contactmridulhere-commits/ana-smart-glasses/hardware/docs/ana-main-render-bottom.png

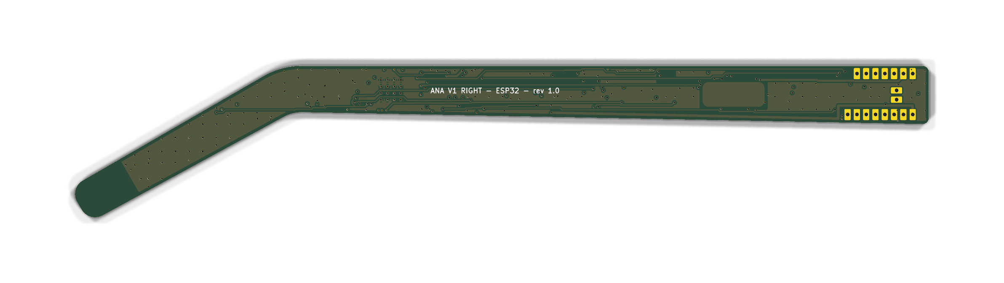
hardware/docs/ana-main-render-bottom.png
