contactmridulhere-commits/ana-smart-glasses/WhatsApp Image 2026-10-10 at 12.55.11 AM (2).jpeg

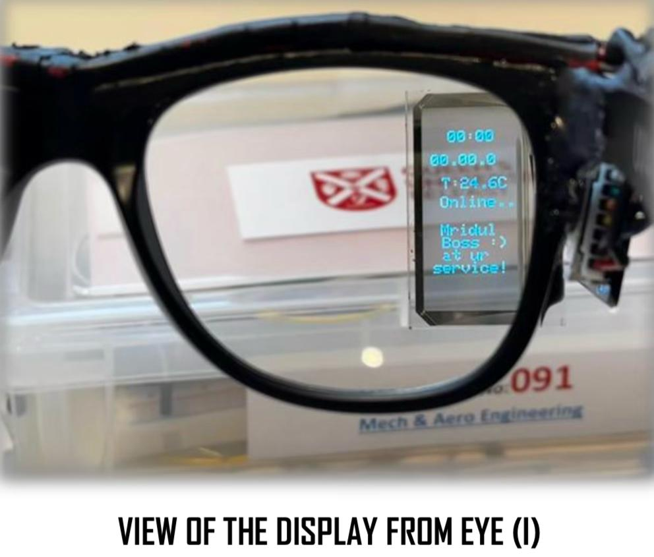
WhatsApp Image 2026-10-10 at 12.55.11 AM (2).jpeg
