contactmridulhere-commits/ana-smart-glasses/With LED's ON.jpeg

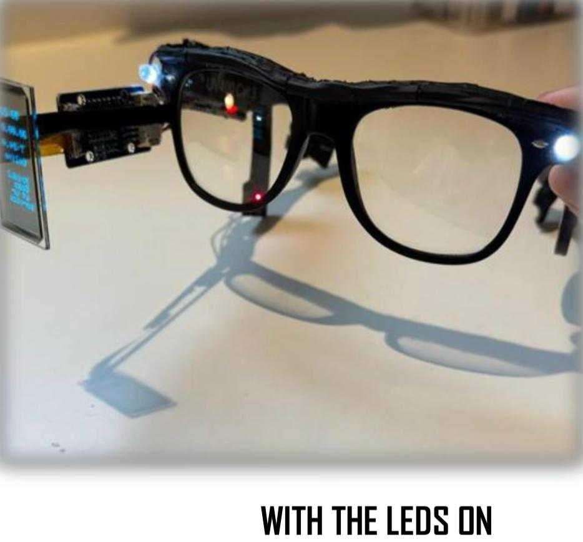
With LED's ON.jpeg
