contactmridulhere-commits/ana-smart-glasses/hardware/docs/ana-power-assembly-top.pdf

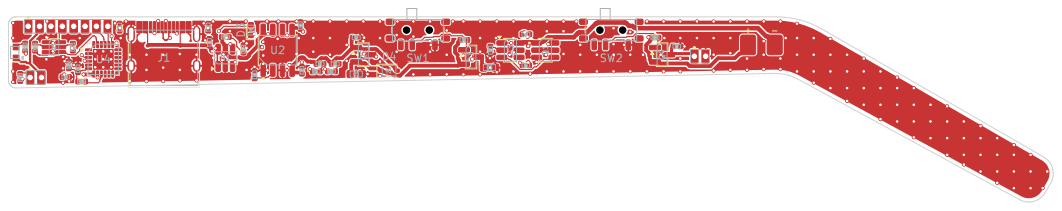
[picture p7: page 1]
