contactmridulhere-commits/ana-smart-glasses/hardware/docs/ana-power-schematic.pdf

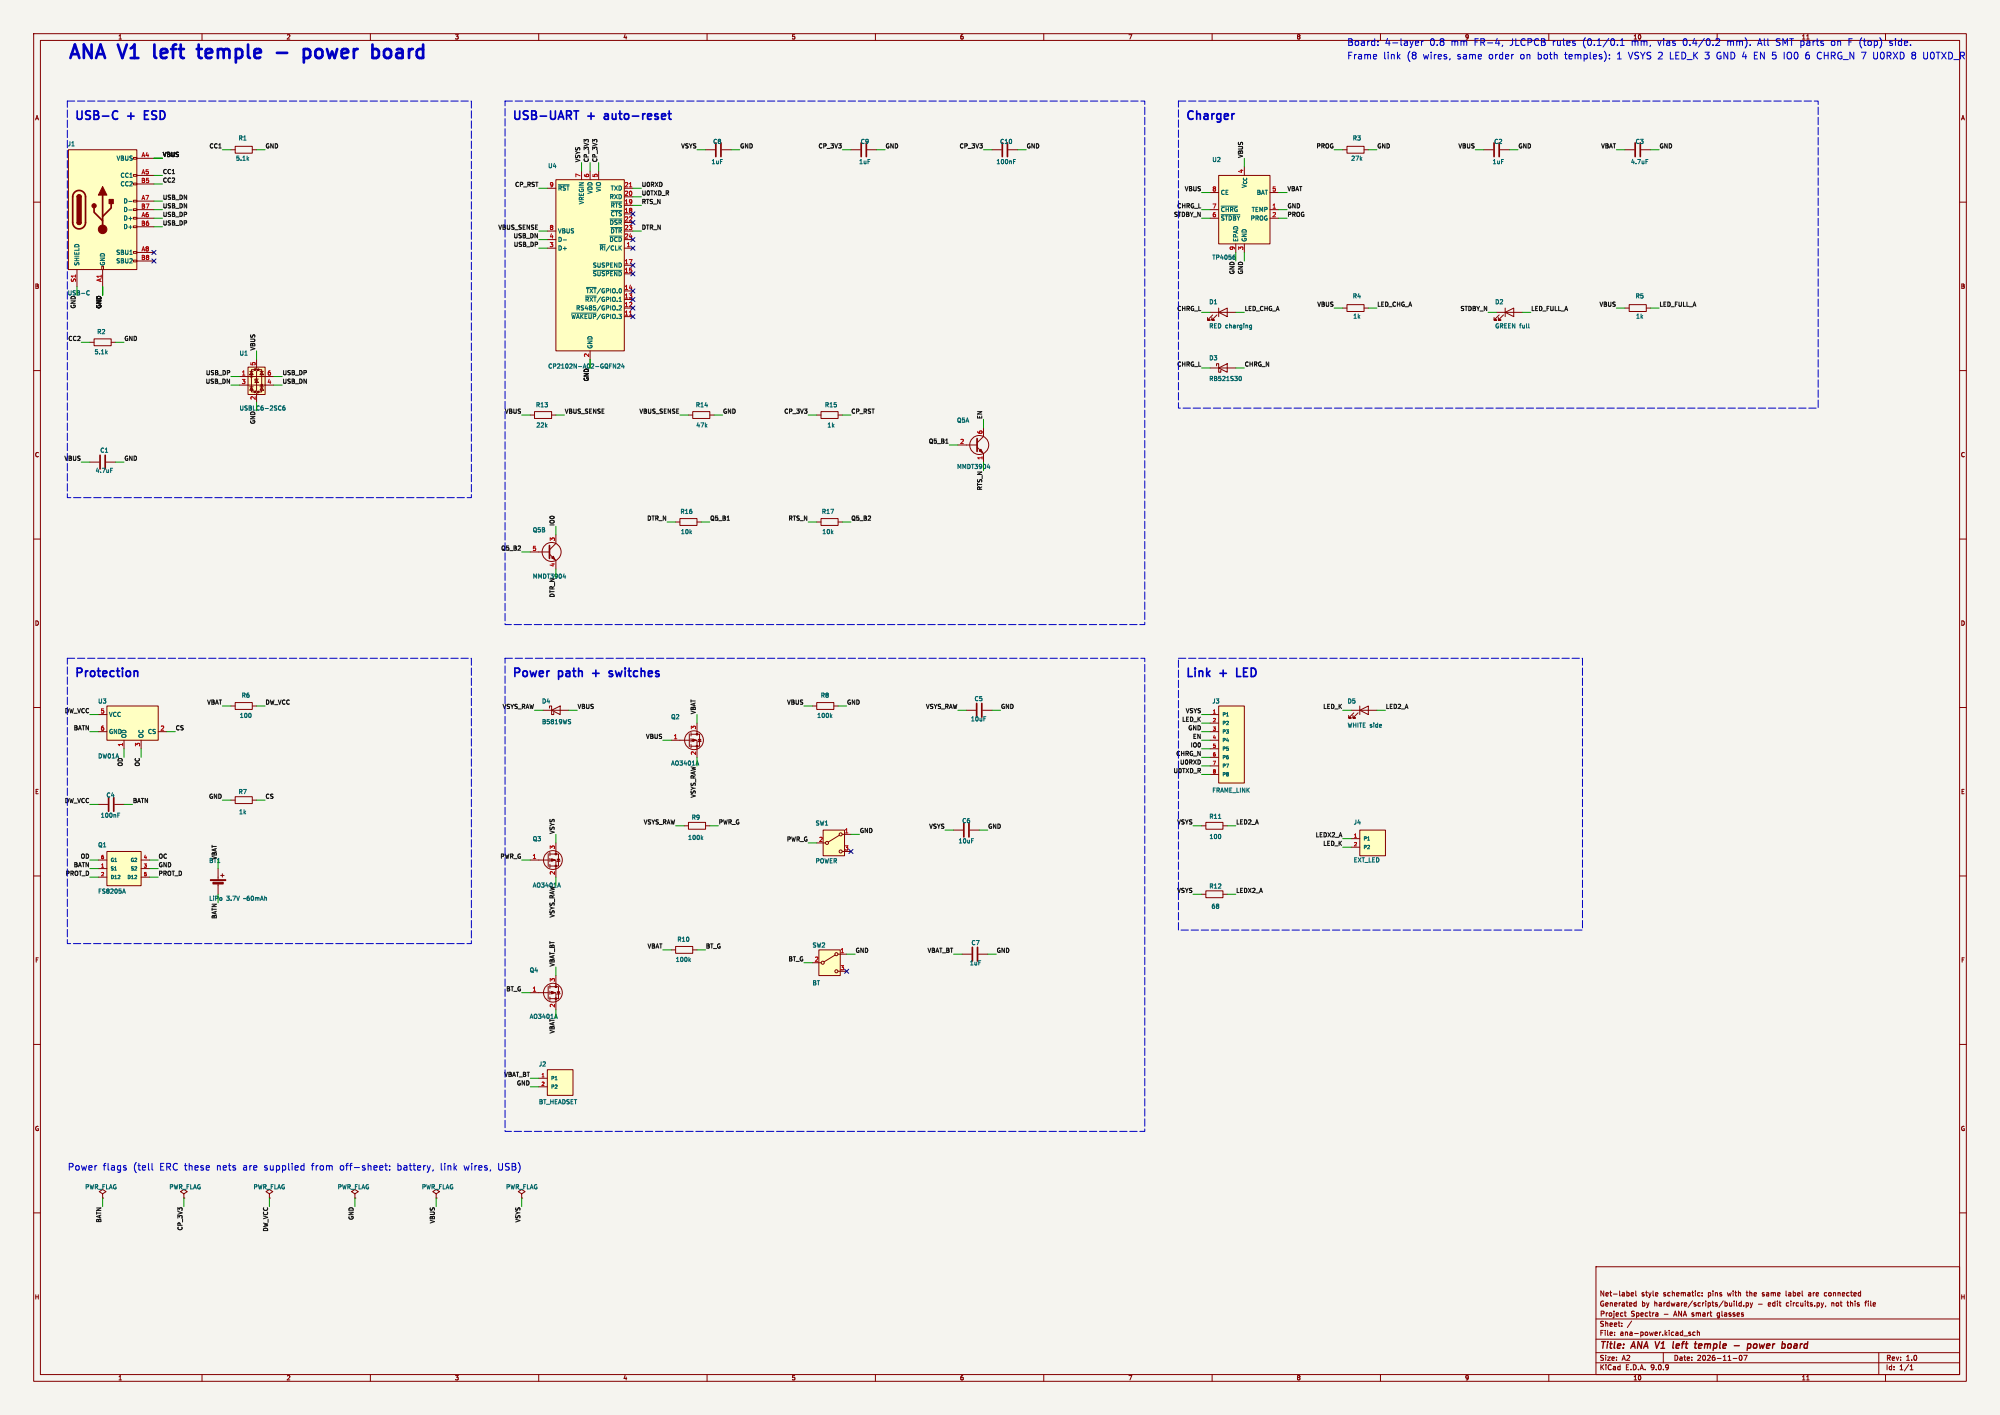
[picture p8: page 1]

5 TXD 21 RXD 20 ~{RTS} 19 ~{CTS} 18 ~{DSR} 22 ~{DTR} 23 ~{DCD} 24 ~{RI}/CLK1 SUSPEND 17 ~{SUSPEND}15 ~{TXT}/GPIO.014 ~{RXT}/GPIO.113 RS485/GPIO.2 12 ~{WAKEUP}/GPIO.311 U4 CP2102N-A02-GQFN24
