contactmridulhere-commits/ana-smart-glasses/hardware/ana-power/ana-power.kicad_pcb

## KiCad design hardware/ana-power/ana-power.kicad_pcb (2026-11-08)

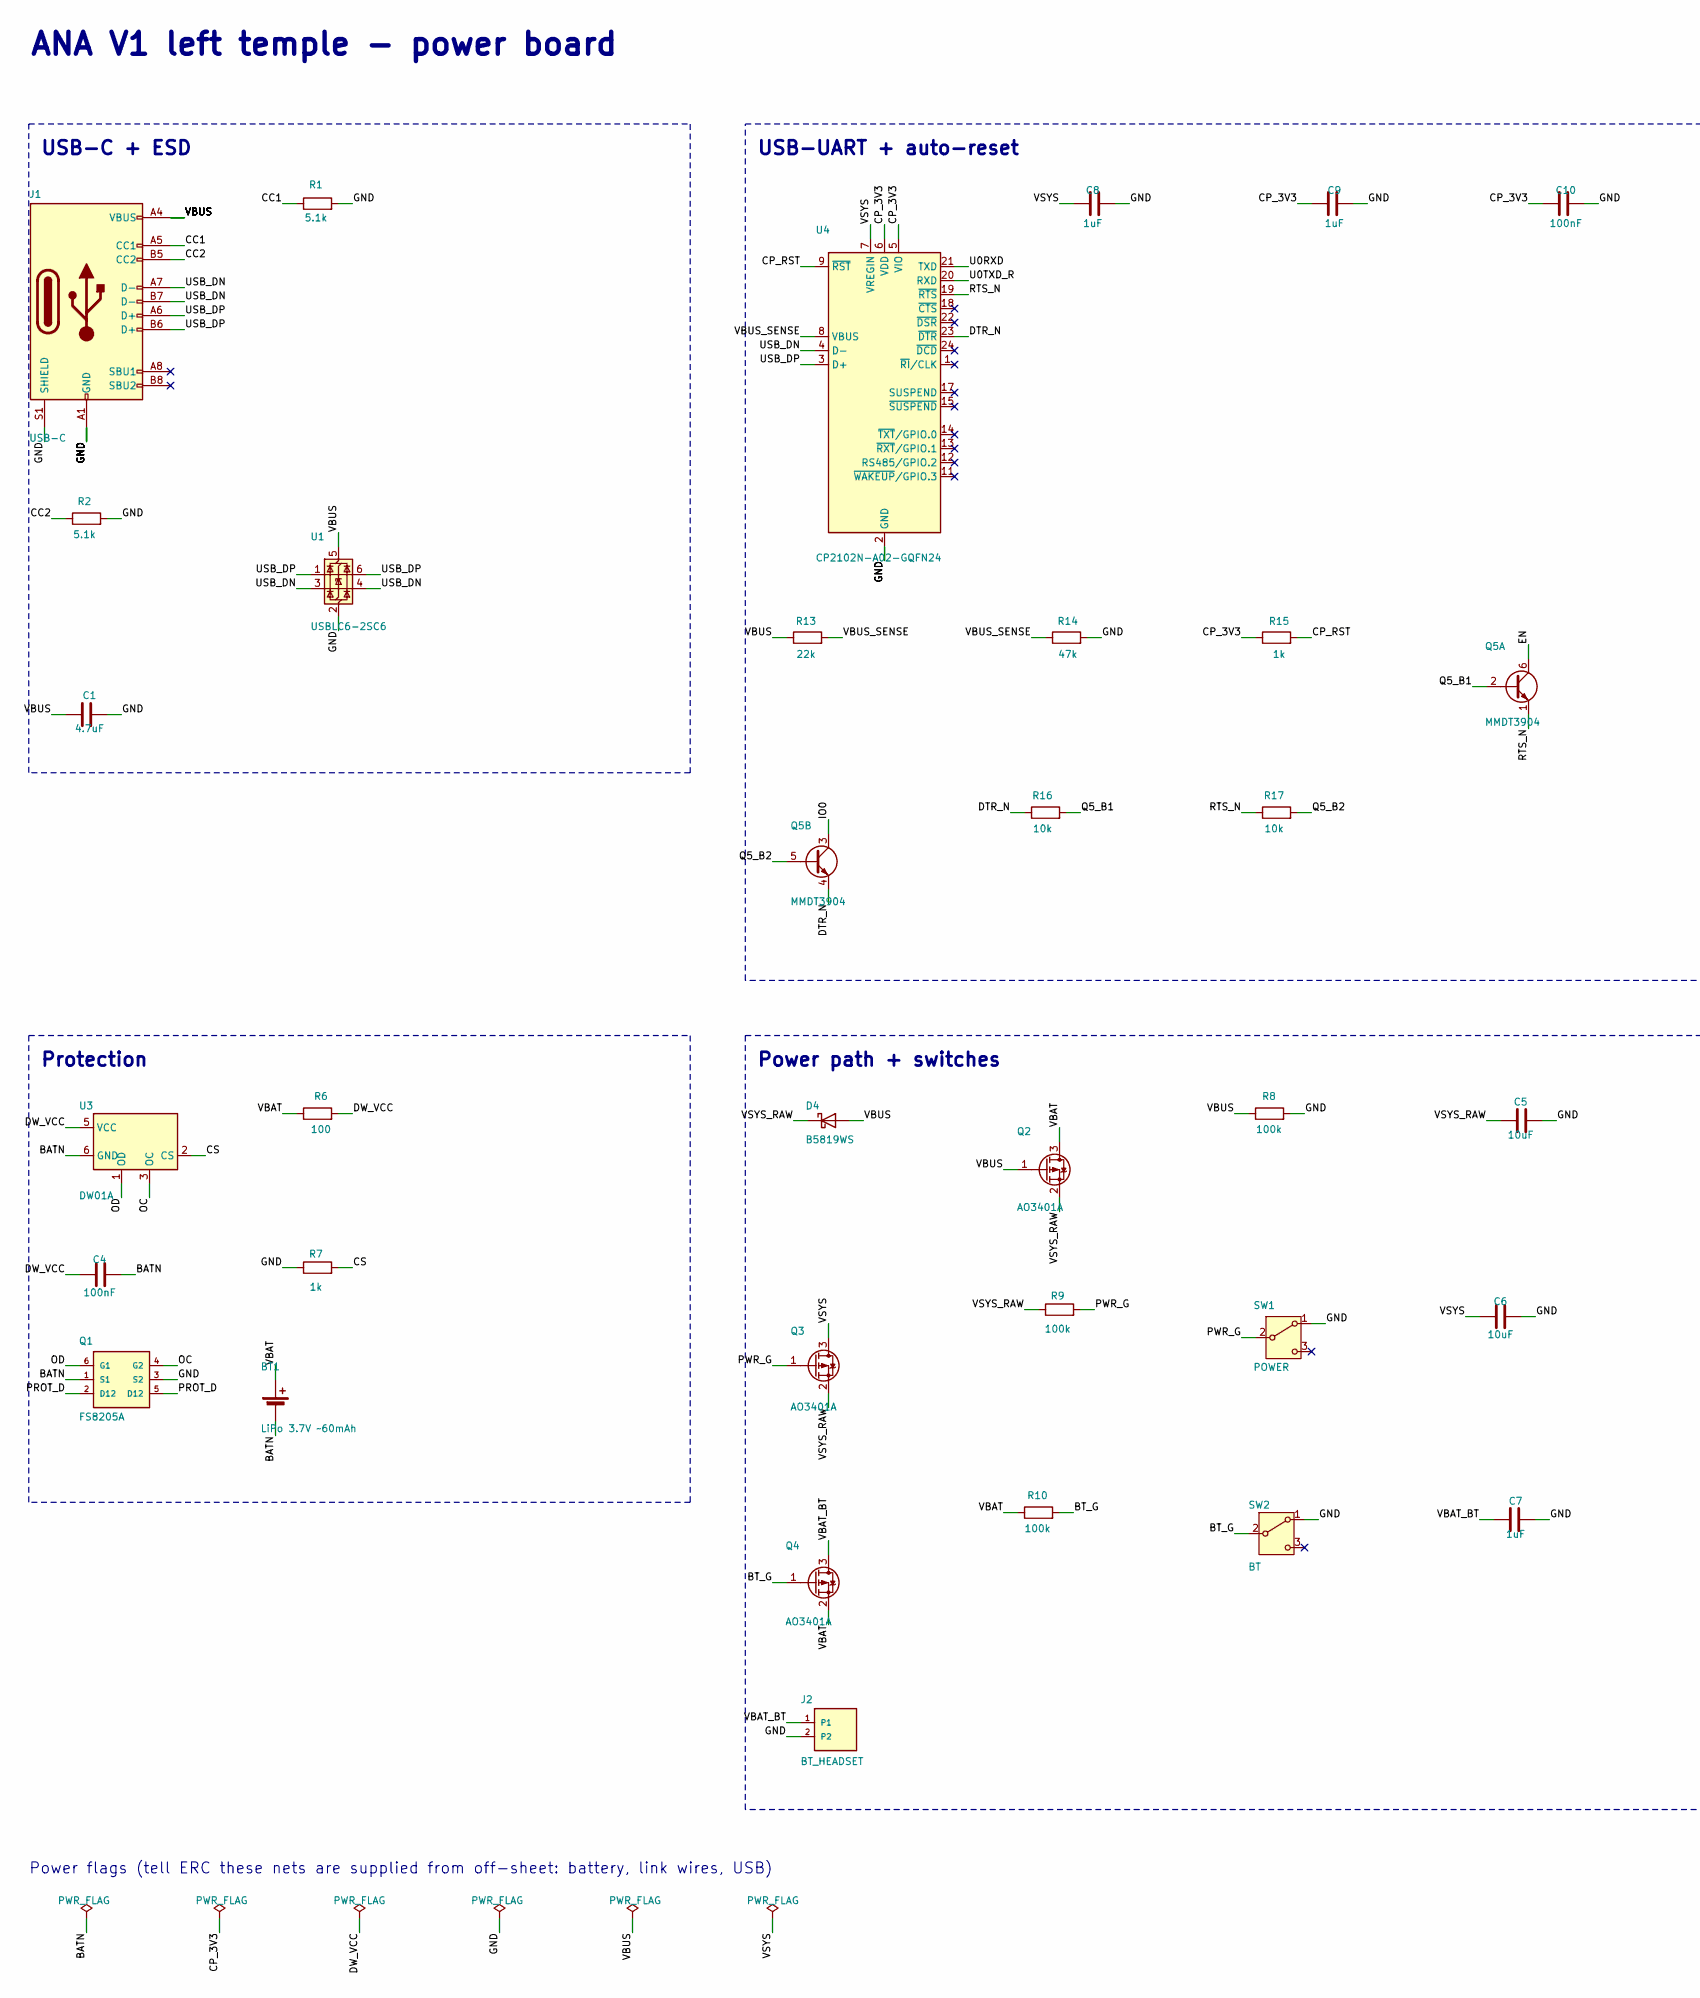
[picture p9: schematic ana-power.kicad_sch, ANA V1 left temple - power board, part in row 1, column 1]

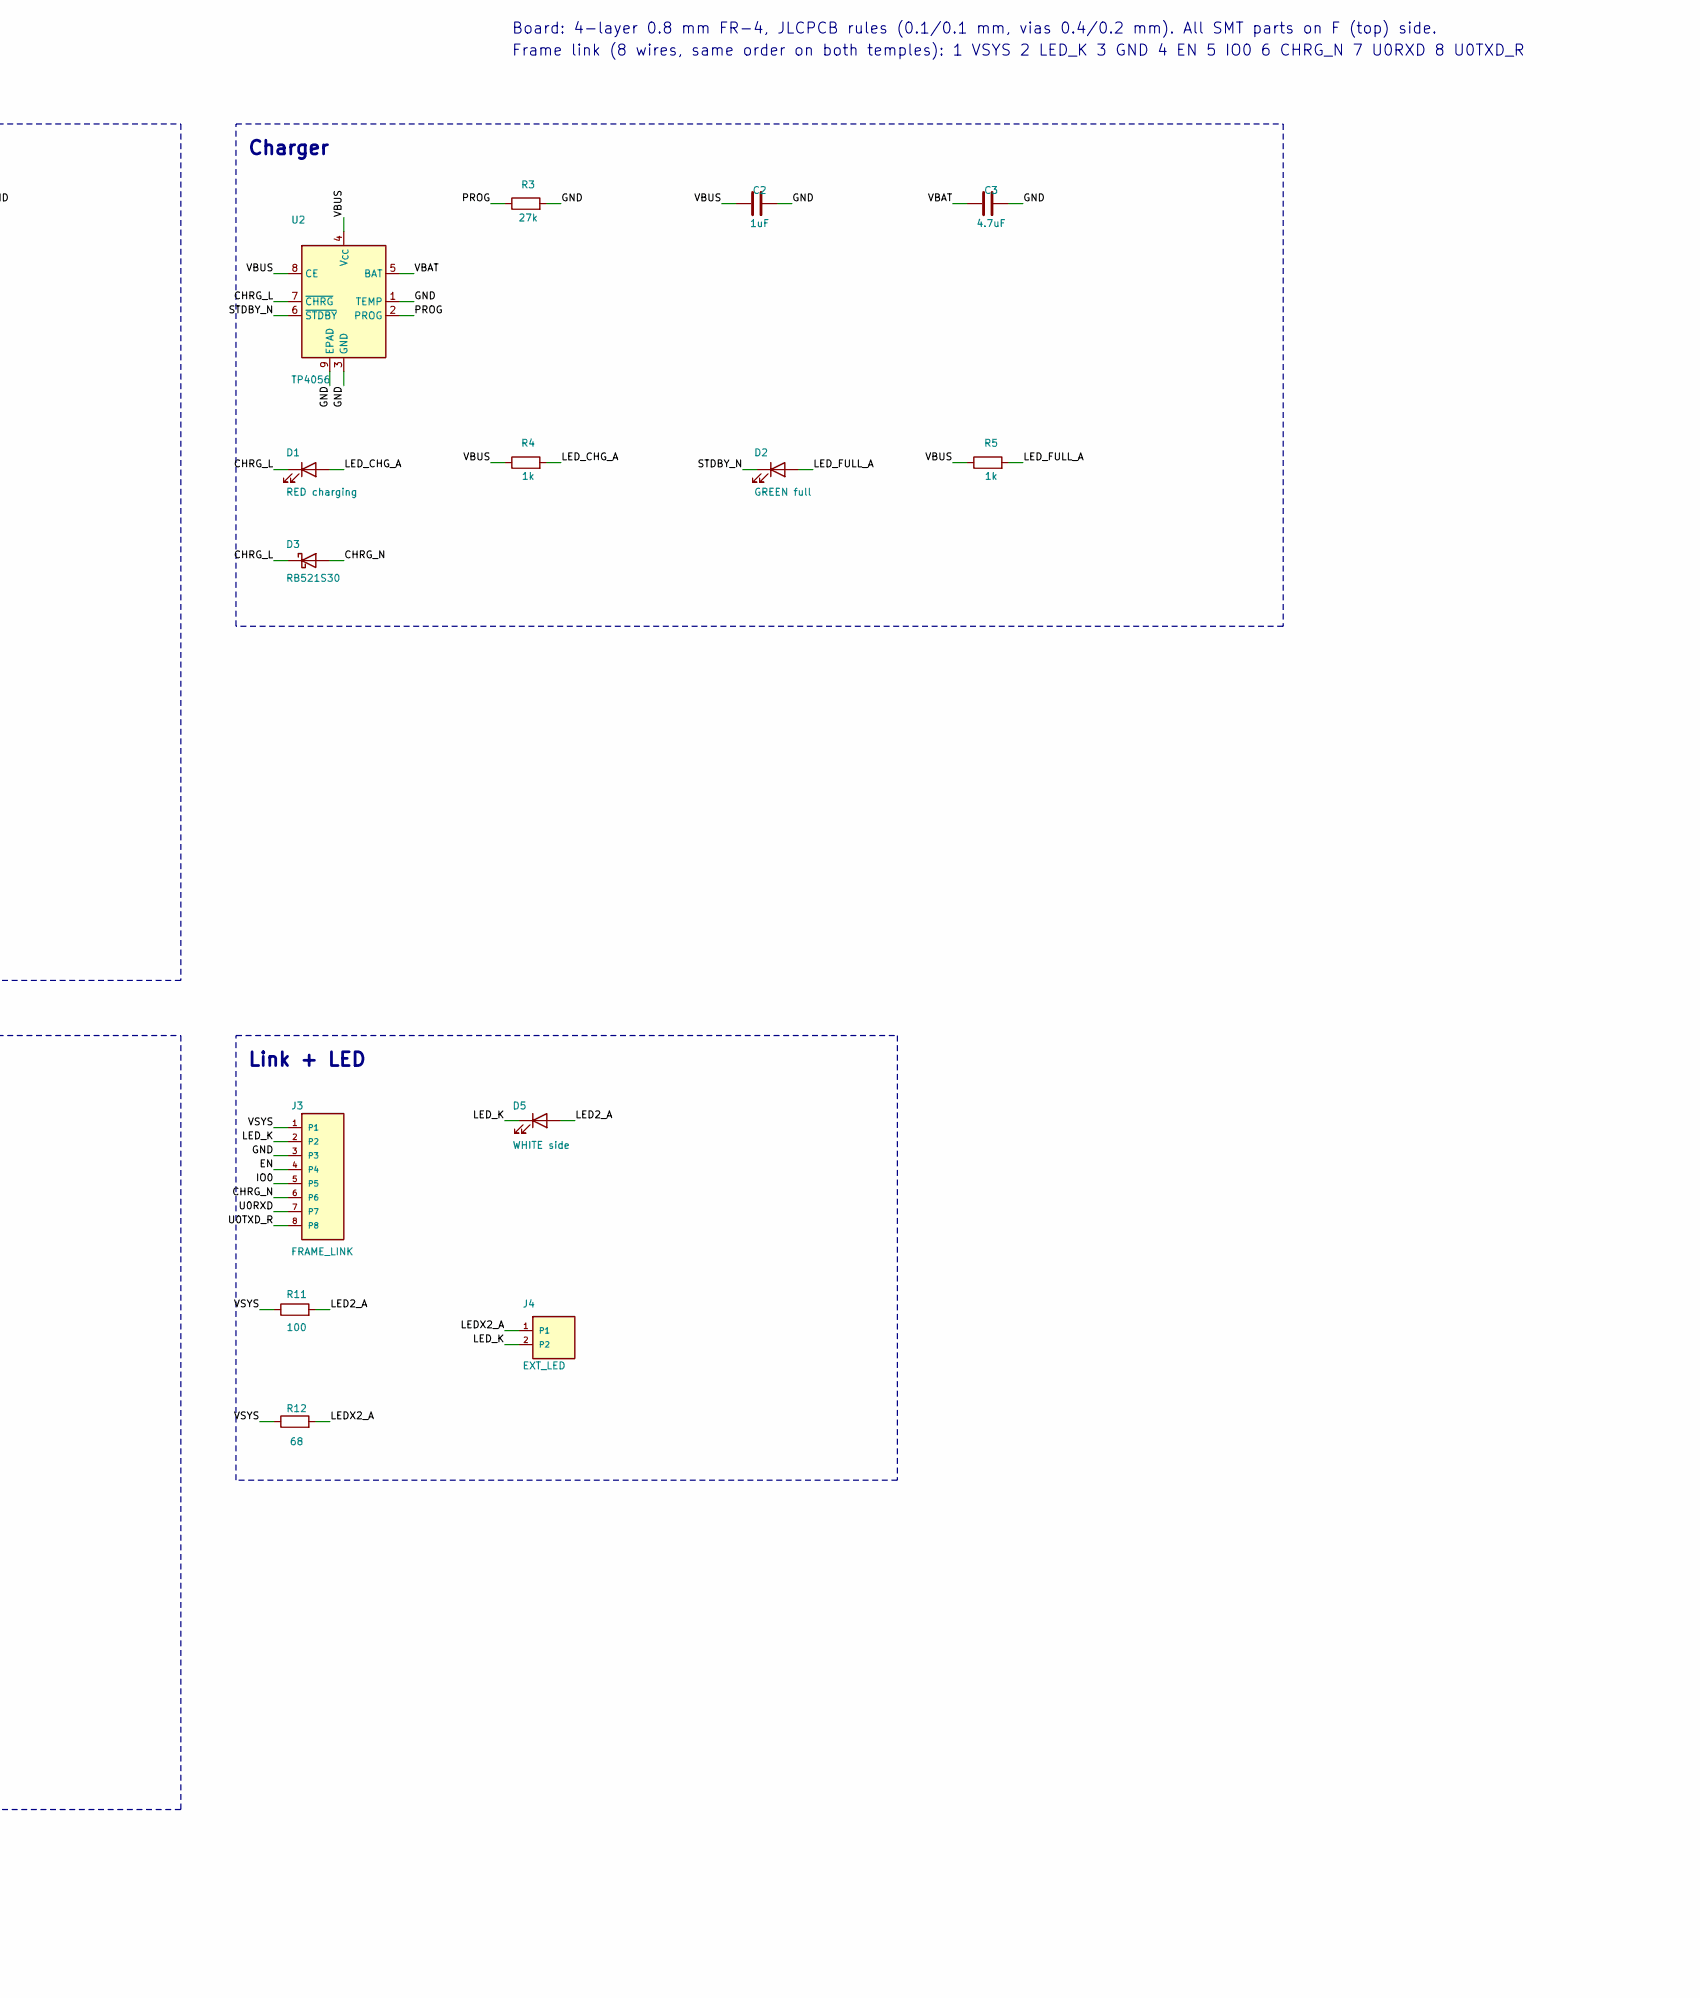
[picture p10: schematic ana-power.kicad_sch, ANA V1 left temple - power board, part in row 1, column 2]

Parts:
BT1: LiPo 3.7V ~60mAh; BatteryPads_2x2.5mm
C1, C3: 4.7uF; C_0402_1005Metric; LCSC C469468
C2, C7, C8, C9: 1uF; C_0402_1005Metric; LCSC C52923
C4, C10: 100nF; C_0402_1005Metric; LCSC C1525
C5, C6: 10uF; C_0603_1608Metric; LCSC C380317
D1: RED charging; LED_0402_1005Metric; MPN NCD0402R1; LCSC C130719
D2: GREEN full; LED_0402_1005Metric; MPN NCD0402G1; LCSC C130723
D3: RB521S30; D_SOD-523; MPN RB521S30T1G; LCSC C145179
D4: B5819WS; D_SOD-323; MPN B5819WS; LCSC C64886
D5: WHITE side; LED_SideView_1.6x0.75mm_YLED0602; MPN YLED0602WSIDE; LCSC C46635136
J1: USB-C; USB_C_Receptacle_HRO_TYPE-C-31-M-12; MPN TYPE-C-31-M-12; LCSC C165948
J2: BT_HEADSET; WirePads_1x02_P1.50mm
J3: FRAME_LINK; WirePads_1x08_P1.50mm
J4: EXT_LED; WirePads_1x02_P1.50mm
Q1: FS8205A; SOT-23-6; MPN FS8205A; LCSC C908265
Q2, Q3, Q4: AO3401A; SOT-23; MPN AO3401A; LCSC C15127
Q5: MMDT3904; SOT-363_SC-70-6; MPN MMDT3904-7-F; LCSC C83572
R1, R2: 5.1k; R_0402_1005Metric; LCSC C25905
R3: 27k; R_0402_1005Metric; LCSC C25771
R4, R5, R7, R15: 1k; R_0402_1005Metric; LCSC C11702
R6, R11: 100; R_0402_1005Metric; LCSC C25076
R8, R9, R10: 100k; R_0402_1005Metric; LCSC C25741
R12: 68; R_0402_1005Metric; LCSC C25131
R13: 22k; R_0402_1005Metric; LCSC C25768
R14: 47k; R_0402_1005Metric; LCSC C25792
R16, R17: 10k; R_0402_1005Metric; LCSC C25744
SW1: POWER; SW_SPDT_Shouhan_MSK12C02; MPN MSK12C02; LCSC C431540
SW2: BT; SW_SPDT_Shouhan_MSK12C02; MPN MSK12C02; LCSC C431540
U1: USBLC6-2SC6; SOT-23-6; MPN USBLC6-2SC6; LCSC C7519
U2: TP4056; HSOP-8-1EP_3.9x4.9mm_P1.27mm_EP2.41x3.1mm; MPN TP4056-42-ESOP8; LCSC C16581
U3: DW01A; SOT-23-6; MPN DW01A; LCSC C351410
U4: CP2102N-A02-GQFN24; QFN-24-1EP_4x4mm_P0.5mm_EP2.6x2.6mm_ThermalVias_NoBottomPad; MPN CP2102N-A02-GQFN24R; LCSC C969151

Connections:
/BATN: BT1.2 (-), C4.2, Q1.1 (S1), U3.6 (GND)
/BT_G: Q4.1 (G), R10.2, SW2.2 (B)
/CC1: J1.A5 (CC1), R1.1
/CC2: J1.B5 (CC2), R2.1
/CHRG_L: D1.1 (K), D3.1 (K), U2.7 (~CHRG)
/CHRG_N: D3.2 (A), J3.6
/CP_3V3: C9.1, C10.1, R15.1, U4.5 (VIO), U4.6 (VDD)
/CP_RST: R15.2, U4.9 (~RST)
/CS: R7.2, U3.2 (CS)
/DTR_N: Q5.4 (E2), R16.1, U4.23 (~DTR)
/DW_VCC: C4.1, R6.2, U3.5 (VCC)
/EN: J3.4, Q5.6 (C1)
/GND: C1.2, C2.2, C3.2, C5.2, C6.2, C7.2, C8.2, C9.2, C10.2, J1.A1 (GND), J1.A12 (GND), J1.B1 (GND), J1.B12 (GND), J1.S1 (SHIELD), J2.2, J3.3, Q1.3 (S2), R1.2, R2.2, R3.2, R7.1, R8.2, R14.2, SW1.1 (A), SW2.1 (A), U1.2 (GND), U2.1 (TEMP), U2.3 (GND), U2.9 (EPAD), U4.2 (GND), U4.25 (GND)
/IO0: J3.5, Q5.3 (C2)
/LED2_A: D5.2 (A), R11.2
/LEDX2_A: J4.1, R12.2
/LED_CHG_A: D1.2 (A), R4.2
/LED_FULL_A: D2.2 (A), R5.2
/LED_K: D5.1 (K), J3.2, J4.2
/OC: Q1.4 (G2), U3.3 (OC)
/OD: Q1.6 (G1), U3.1 (OD)
/PROG: R3.1, U2.2 (PROG)
/PROT_D: Q1.2 (D12), Q1.5 (D12)
/PWR_G: Q3.1 (G), R9.2, SW1.2 (B)
/Q5_B1: Q5.2 (B1), R16.2
/Q5_B2: Q5.5 (B2), R17.2
/RTS_N: Q5.1 (E1), R17.1, U4.19 (~RTS)
/STDBY_N: D2.1 (K), U2.6 (~STDBY)
/U0RXD: J3.7, U4.21 (TXD)
/U0TXD_R: J3.8, U4.20 (RXD)
/USB_DN: J1.A7 (D-), J1.B7 (D-), U1.3 (I/O2), U1.4 (I/O2), U4.4 (D-)
/USB_DP: J1.A6 (D+), J1.B6 (D+), U1.1 (I/O1), U1.6 (I/O1), U4.3 (D+)
/VBAT: BT1.1 (+), C3.1, Q2.3 (D), Q4.2 (S), R6.1, R10.1, U2.5 (BAT)
/VBAT_BT: C7.1, J2.1, Q4.3 (D)
/VBUS: C1.1, C2.1, D4.2 (A), J1.A4 (VBUS), J1.A9 (VBUS), J1.B4 (VBUS), J1.B9 (VBUS), Q2.1 (G), R4.1, R5.1, R8.1, R13.1, U1.5 (VBUS), U2.4 (V_{CC}), U2.8 (CE)
/VBUS_SENSE: R13.2, R14.1, U4.8 (VBUS)
/VSYS: C6.1, C8.1, J3.1, Q3.3 (D), R11.1, R12.1, U4.7 (VREGIN)
/VSYS_RAW: C5.1, D4.1 (K), Q2.2 (S), Q3.2 (S), R9.1

Notes on the sheet:
ANA V1 left temple - power board
Board: 4-layer 0.8 mm FR-4, JLCPCB rules (0.1/0.1 mm, vias 0.4/0.2 mm). All SMT parts on F (top) side.
Frame link (8 wires, same order on both temples): 1 VSYS 2 LED_K 3 GND 4 EN 5 IO0 6 CHRG_N 7 U0RXD 8 U0TXD_R
USB-C + ESD
USB-UART + auto-reset
Charger
Protection
Power path + switches
Link + LED
Power flags (tell ERC these nets are supplied from off-sheet: battery, link wires, USB)

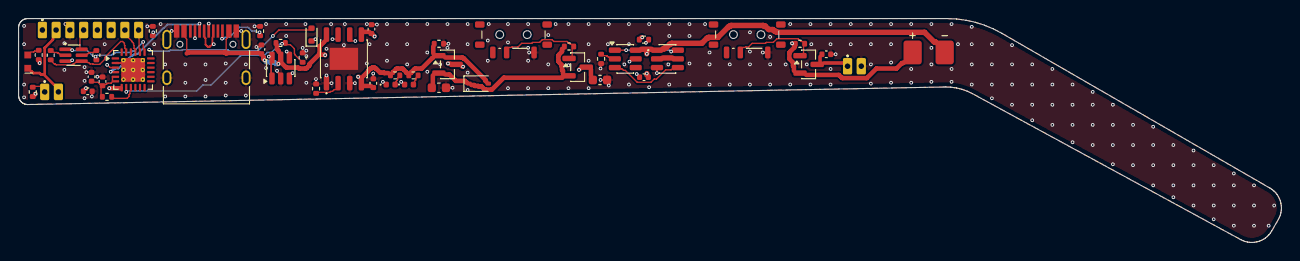
[picture p11: board ana-power.kicad_pcb from above]

Board: 4 copper layers, 137.8 x 24.4 mm, 48 parts (0 on the bottom side), 38 nets.
