contactmridulhere-commits/ana-smart-glasses/hardware/ana-main/ana-main.kicad_pcb

## KiCad design hardware/ana-main/ana-main.kicad_pcb (2026-11-08)

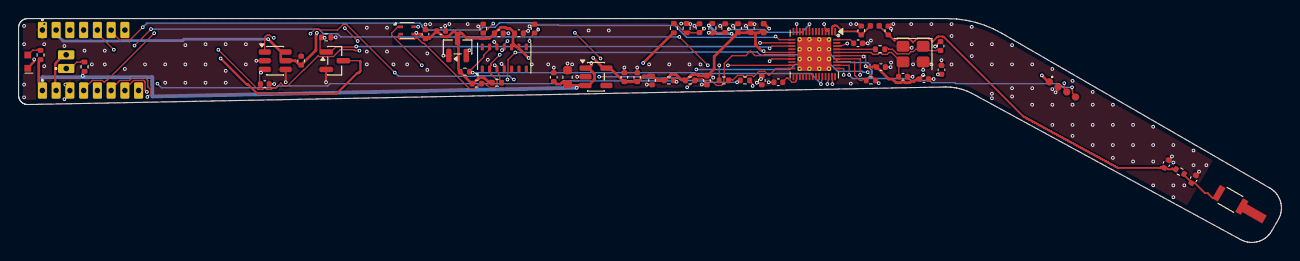
[picture p12: board ana-main.kicad_pcb from above]

Board: 4 copper layers, 137.8 x 24.4 mm, 63 parts (1 on the bottom side), 35 nets.

Parts:
AE1: ANT3216LL00R2400A; ANT_Yageo_ANT3216LL00R2400A
C1, C21, C27: 10uF; C_0402_1005Metric
C2, C6, C9, C12, C20, C22, C29, C31: 1uF; C_0402_1005Metric
C3, C4, C7, C8, C23, C28, C30, C32, C33: 100nF; C_0402_1005Metric
C5: 100pF; C_0402_1005Metric
C10: 10nF; C_0402_1005Metric
C13, C14, C34: 22pF; C_0402_1005Metric
C15, C16, C17, C18: 1.5pF; C_0402_1005Metric
C19: 10uF; C_0603_1608Metric
D1: WHITE side; LED_SideView_1.6x0.75mm_YLED0602
E1: TOUCH; TouchElectrode_4x10mm_Back
J1: FRAME_LINK; WirePads_1x08_P1.50mm
J2: DEBUG; TestPads_1x04_P1.10mm
J3: EXT_LED; WirePads_1x02_P1.50mm
J4: OLED; WirePads_1x07_P1.50mm
L1, L2: 2.0nH; L_0402_1005Metric
Q2: AO3400A; SOT-23
R2, R3, R19: 10k; R_0402_1005Metric
R4, R8: 0; R_0402_1005Metric
R5: 470; R_0402_1005Metric
R6, R7: 33; R_0402_1005Metric
R9, R10, R11, R20: 100k; R_0402_1005Metric
R17, R18: 4.7k; R_0402_1005Metric
R21: 100; R_0402_1005Metric
R22: 68; R_0402_1005Metric
U1: ESP32-U4WDH; QFN-48-1EP_5x5mm_P0.35mm_EP3.7x3.7mm_ThermalVias_NoBottomPad
U2: AP2112K-3.3; SOT-23-5
U4: MAX30102; Maxim_OLGA-14_3.3x5.6mm_P0.8mm
U5: XC6206P182MR; SOT-23
U6: SHT40-AD1B; Sensirion_DFN-4_1.5x1.5mm_P0.8mm_SHT4x_NoCentralPad
U7: TTP223-BA6; SOT-23-6
Y1: 40MHz 10ppm; Crystal_SMD_3225-4Pin_3.2x2.5mm

Connections:
/1V8: C29.1, C30.1, U4.11, U5.2
/3V3: C1.1, C2.1, C3.1, C4.1, C5.1, C6.1, C7.1, C8.1, C21.1, C22.1, C27.1, C28.1, C31.1, C32.1, C33.1, J2.1, J4.2, L1.1, R2.1, R3.1, R11.1, R17.1, R18.1, R19.1, U1.1, U1.19, U1.37, U1.43, U1.46, U2.5, U4.9, U4.10, U5.3, U6.3, U7.5, U7.6
/BAT_ADC: C23.1, R9.2, R10.1, U1.13
/CAP1: C10.1, U1.48
/CHRG_N: J1.6, R11.2, U1.20
/EN: C12.1, J1.4, R2.2, U1.9
/GND: C1.2, C2.2, C3.2, C4.2, C5.2, C6.2, C7.2, C8.2, C9.2, C10.2, C12.2, C13.2, C14.2, C15.2, C16.2, C17.2, C18.2, C19.2, C20.2, C21.2, C22.2, C23.2, C27.2, C28.2, C29.2, C30.2, C31.2, C32.2, C33.2, C34.2, J1.3, J2.2, J4.1, Q2.2, R10.2, R20.2, U1.49, U2.2, U4.4, U4.12, U5.1, U6.4, U7.2, U7.4, Y1.2, Y1.4
/I2C_SCL: R18.2, U1.39, U4.2, U6.2
/I2C_SDA: R17.2, U1.42, U4.3, U6.1
/IO0: J1.5, R3.2, U1.23
/LED1_A: D1.2, R21.2
/LEDX1_A: J3.1, R22.2
/LED_K: D1.1, J1.2, J3.2, Q2.3
/LNA_IN: C15.1, L2.1, U1.2
/MAX_INT: R19.2, U1.34, U4.13
/OLED_CS: J4.7, U1.21
/OLED_DC: J4.6, U1.15
/OLED_RST: J4.5, U1.16
/RF_FEED: AE1.1, C18.1, R8.2
/RF_MID: C16.1, C17.1, L2.2, R8.1
/SPI_CLK: J4.3, R6.2
/SPI_CLK_MCU: R6.1, U1.24
/SPI_MOSI: J4.4, R7.2
/SPI_MOSI_MCU: R7.1, U1.36
/TOUCH: Q2.1, R20.1, U1.17, U7.1
/TOUCH_PAD: C34.1, E1.1, U7.3
/U0RXD: J1.7, J2.4, U1.40
/U0TXD: R5.1, U1.41
/U0TXD_R: J1.8, J2.3, R5.2
/VDD3P3: L1.2, U1.3, U1.4
/VDD_SDIO: C9.1, U1.26
/VSYS: C19.1, C20.1, J1.1, R9.1, R21.1, R22.1, U2.1, U2.3
/XTAL_IN: C13.1, R4.2, Y1.1
/XTAL_N: C14.1, U1.44, Y1.3
/XTAL_P: R4.1, U1.45
