contactmridulhere-commits/ana-smart-glasses/(commit log)

2026-09-27 Add README: V1 firmware, wiring, build steps and V2 roadmap
2026-11-08 Add temple PCB designs (KiCad 9) and adapt firmware
    - hardware/: generated KiCad projects for the two temple boards
    (ana-main: ESP32-U4WDH, CP2102N, MAX30102, SHT40, TTP223, antenna;
    ana-power: USB-C, TP4056, DW01A/FS8205A, power path, switches)
    - parametric temple outline (config/temple.json), placement, own grid
    router, ERC/DRC/parity checks, JLCPCB exports
    - firmware: ANA_TEMPLE_PCB pin map, SHT40, battery/charge status, touch
    - work in progress: right-temple board routing still being finalised
    Claude-Session: https://claude.ai/code/session_019fckjMUZgfdY44xscdYdyq
2026-11-08 WIP: temple PCB routing rework (router connectivity, undoable rip-up, layout spread)
    Router: copper only counts as connected when it really joins the tree; escape stubs survive rip-up;
    rip-up rounds are undone when they make things worse; dangling copper is pruned; footprint keep-outs
    and edge distance handled conservatively. Main board: CP2102N cluster moved to the hinge end, ESP32
    support parts in two edge rows, ESP32 footprint without bottom pad, SHT40 without slot.
    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
2026-11-08 WIP: left temple complete (0 ERC/DRC/unconnected/parity), router upgrades, right temple re-layout
    Router: blocker-based rip-up with undo, depth-1 repair, In2 routing on the right temple, layer direction
    costs, fixed escapes kept through rip-up, dangling-copper prune, pin-1 silk cleanup. Left temple exported
    (gerbers, drill, BOM/CPL, PDFs, renders).
    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
2026-11-08 Finish temple PCBs: both boards pass ERC/DRC/parity with 0 unconnected
    - Move the CP2102N USB-serial and DTR/RTS auto-reset to the left temple next
    to the USB-C socket; the frame link now carries VSYS, LED_K, GND, EN, IO0,
    CHRG, RX and TX instead of USB data and VBUS
    - CP2102N uses a thermal-via QFN-24 footprint without a bottom pad; its GND
    pin is tied to the exposed pad
    - Right temple bring-up pads reduced to 3V3/GND/TX/RX and moved into the free
    upper part of the ear tip (EN/IO0 are on the frame-link pads)
    - Router cleanup pass: shorten tracks at T-junctions instead of deleting
    them, and replace single-layer vias with links instead of cutting the
    tracks they joined; late GND f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
